chieftain0/ValenTtiny/schematic/schematic.png

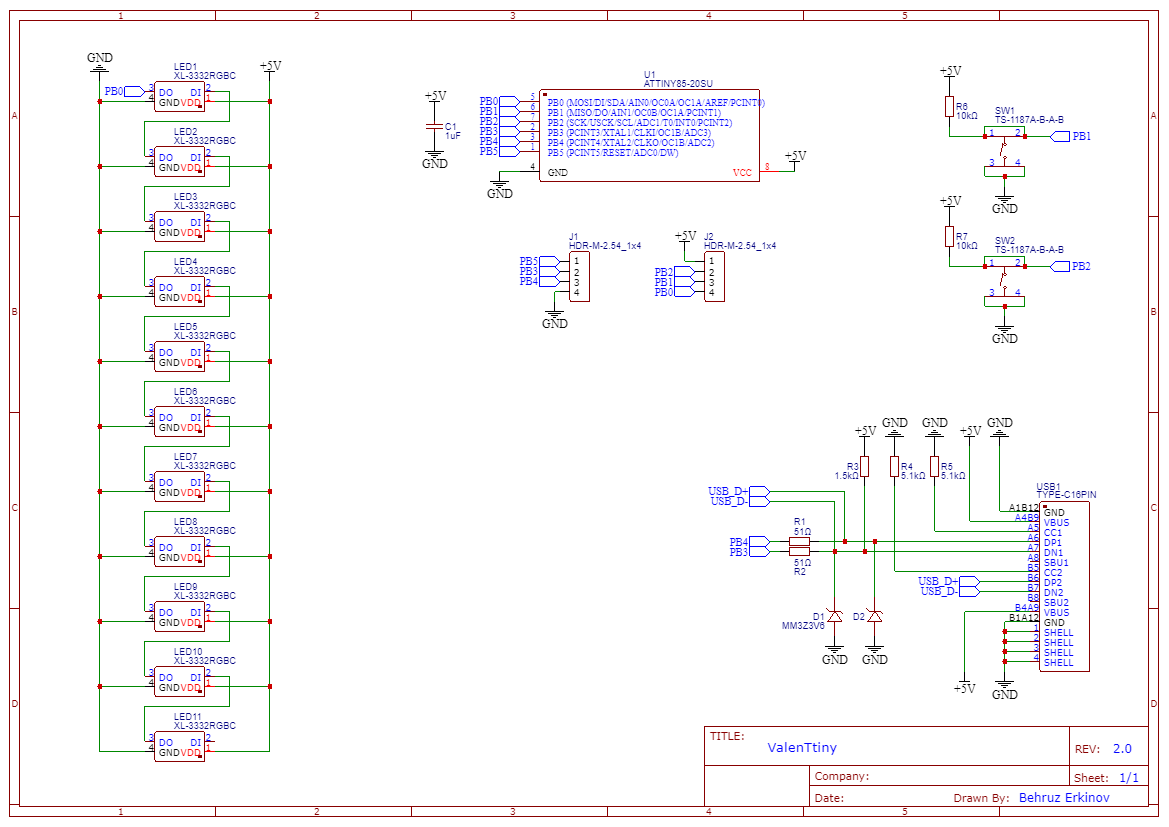
schematic/schematic.png
