chieftain0/ValenTtiny/gerber/bom.csv

ID | Name | Designator | Footprint | Quantity | Manufacturer Part | Manufacturer | Supplier | Supplier Part | Price | Pins | 3DModel | Contributor | JLCPCB Part Class | link
1 | XL-3332RGBC | LED11,LED1,LED2,LED3,LED4,LED5,LED6,LED7,LED8,LED9,LED10 | LED-SMD_4P-L3.3-W3.2_XL-3332RGBC-WS2812B | 11 | XL-3332RGBC-WS2812B | XINGLIGHT(成兴光) | LCSC | C42400839 | 0.035 | 4 | LED-SMD_4P-L3.3-W3.2_XL-3332RGBC-WS2812B | lcsc | Extended Part | https://atta.szlcsc.com/upload/public/pdf/source/20241129/60F71A84DB48E63D636A05BF6CE6F6D6.pdf
2 | 51Ω | R1,R2 | R0805 | 2 | 0805W8F510JT5E | UNI-ROYAL(厚声) | LCSC | C17738 | 0.002 | 2 | R0805_L2.0-W1.3-H0.6 | lcsc | Basic Part | https://item.szlcsc.com/142685.html
3 | 10kΩ | R6,R7 | R0805 | 2 | 0805W8F1002T5E | UNI-ROYAL(厚声) | LCSC | C17414 | 0.002 | 2 | R0805_L2.0-W1.3-H0.6 | lcsc | Basic Part | https://item.szlcsc.com/142685.html
4 | 5.1kΩ | R4,R5 | R0805 | 2 | 0805W8F5101T5E | UNI-ROYAL(厚声) | LCSC | C27834 | 0.002 | 2 | R0805_L2.0-W1.3-H0.6 | lcsc | Basic Part | https://item.szlcsc.com/142685.html
5 | TYPE-C16PIN | USB1 | USB-C-SMD_TYPE-C16PIN | 1 | TYPE-C16PIN | SHOU HAN(首韩) | LCSC | C393939 | 0.066 | 16 | USB-C-SMD_TYPE-C16PIN | LCSC | Extended Part | https://item.szlcsc.com/372551.html
6 | MM3Z3V6 | D1,D2 | SOD-323_L1.7-W1.3-LS2.6-RD | 2 | MM3Z3V6 | R+O(宏嘉诚) | LCSC | C19077454 | 0.017 | 2 | SOD-323_L1.7-W1.3-LS2.6-RD | lcsc | Extended Part | https://atta.szlcsc.com/upload/public/pdf/source/20200225/C485496_BB753C4664B20481CFEA6C9542536A94.pdf
7 | HDR-M-2.54_1x4 | J1,J2 | HDR-M-2.54_1X4 | 2 |  |  | LCSC | C124378 | 0.046 | 4 | HDR-M-2.54_1x4 | LCEDA_Lib
8 | 1uF | C1 | C0805 | 1 | CL21B105KBFNNNE | SAMSUNG(三星) | LCSC | C28323 | 0.009 | 2 | C0805_L2.0-W1.3-H1.3 | lcsc | Basic Part | https://item.szlcsc.com/373011.html
9 | TS-1187A-B-A-B | SW1,SW2 | SW-SMD_4P-L5.1-W5.1-P3.70-LS6.5-TL_H1.5 | 2 | TS-1187A-B-A-B | XKB Connectivity(中国星坤) | LCSC | C318884 | 0.019 | 4 | SW-SMD_4P-L5.1-W5.1-P3.70-LS6.5-TL_H1.5 | LCSC | Basic Part | https://item.szlcsc.com/datasheet/TS-1187A-C-6.0-B/299982.html
10 | ATTINY85-20SU | U1 | SOIC-8_L5.3-W5.3-P1.27-LS8.0-BL | 1 | ATTINY85-20SU | MICROCHIP(美国微芯) | LCSC | C89852 | 3.402 | 8 | SOIC-8_L5.3-W5.3-H1.9-LS7.9-P1.27 | lcsc | Extended Part | https://item.szlcsc.com/63461.html
11 | 1.5kΩ | R3 | R0805 | 1 | 0805W8F1501T5E | UNI-ROYAL(厚声) | LCSC | C4310 | 0.002 | 2 | R0805_L2.0-W1.3-H0.6 | lcsc | Basic Part | https://item.szlcsc.com/142685.html
