chieftain0/ValenTtiny/schematic/schematic.pdf

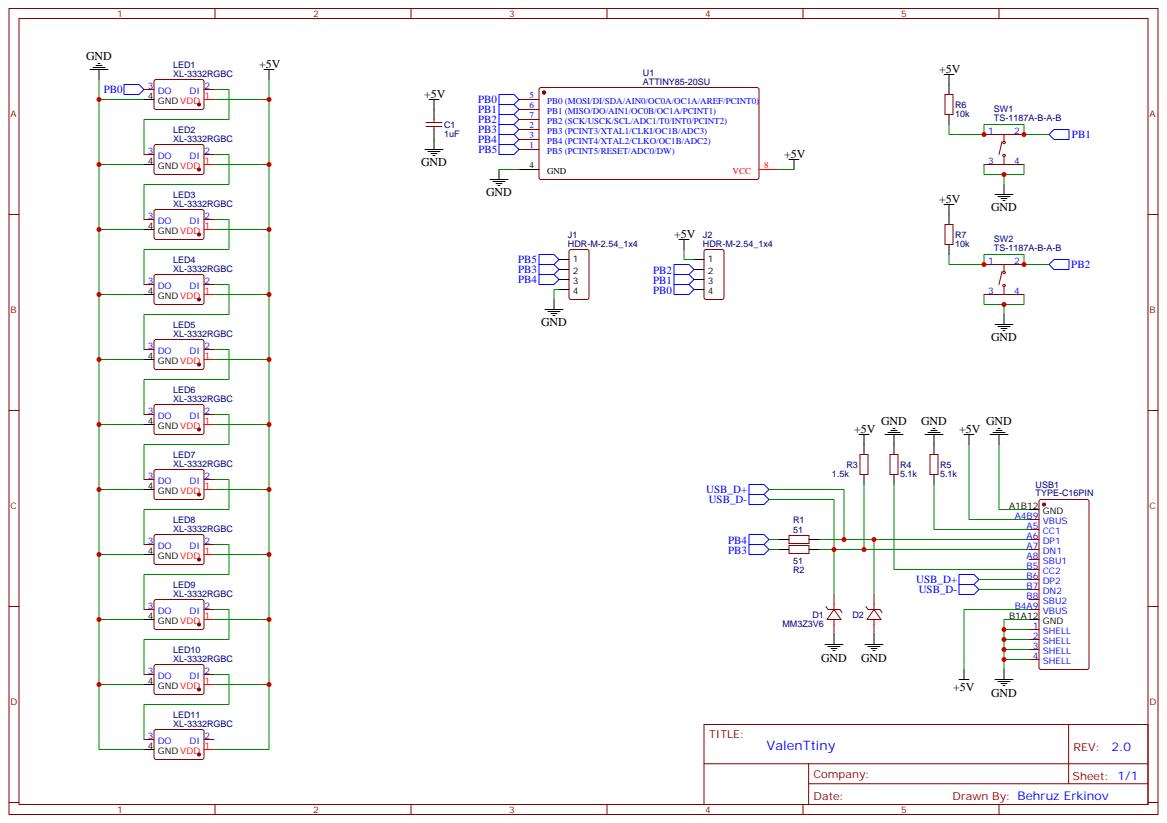
[picture p2: page 1]

Drawn By: Behruz Erkinov
