chieftain0/ValenTtiny/(commit log)

2024-12-06 added button controls
2024-12-07 Fix button
2024-12-14 added schematic, gerber and wokwi project
2025-01-04 updated schematics and gerber
2025-01-07 modified pcb
2025-01-17 add TH board
2025-01-21 add SMD gerber
2025-01-23 update gerbers
2025-01-26 update SMD gerber
2025-02-04 SMD BOM optimization
2025-02-15 update schematic, gerber and BOM
2025-02-15 update gerber
2025-02-18 swapped button pins
2025-07-06 migration to SMD-only PCBs
2025-08-22 reduced flash usage by 414 bytes (6.28%) by implementing own button polling
2025-08-22 timer overflow fix
2025-08-22 schematic update
2025-08-22 added pin headers for ease of use
    [bom.csv]
2025-08-22 fix bom
    [bom.csv]
2025-09-28 migration to different LEDs
    [bom.csv, pp.csv]
